ashrafi91/SmartPlant/ATmega328P_LCD_BMP180_LM35_Moisture_sensors/Pictures/ATmega328P_LCD_BMP180_LM35_Moisture_sensors_3.jpg

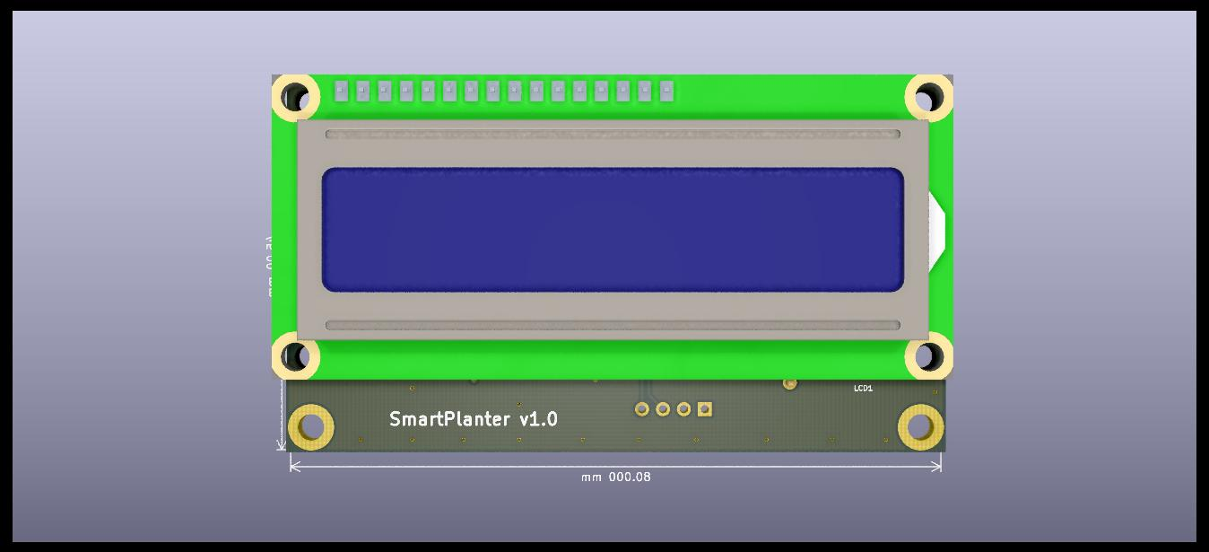
ATmega328P_LCD_BMP180_LM35_Moisture_sensors/Pictures/ATmega328P_LCD_BMP180_LM35_Moisture_sensors_3.jpg
