ashrafi91/SmartPlant/1st Version Enclosure S1/Render A.jpg

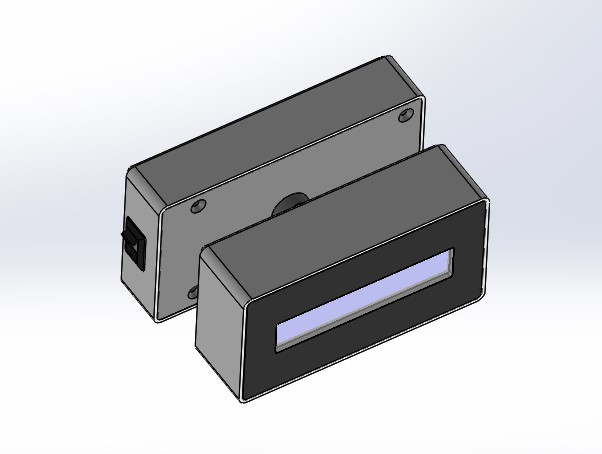
1st Version Enclosure S1/Render A.jpg
