ashrafi91/SmartPlant/1st Version Enclosure S1/Render B.jpg

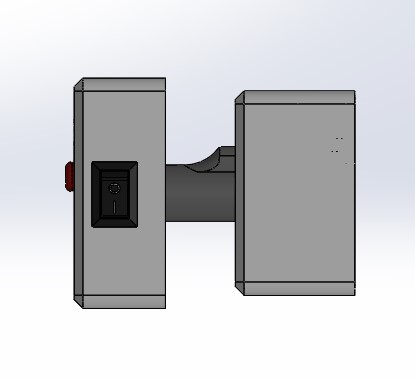
1st Version Enclosure S1/Render B.jpg
