ashrafi91/SmartPlant/1st Version Enclosure S1/Render C.jpg

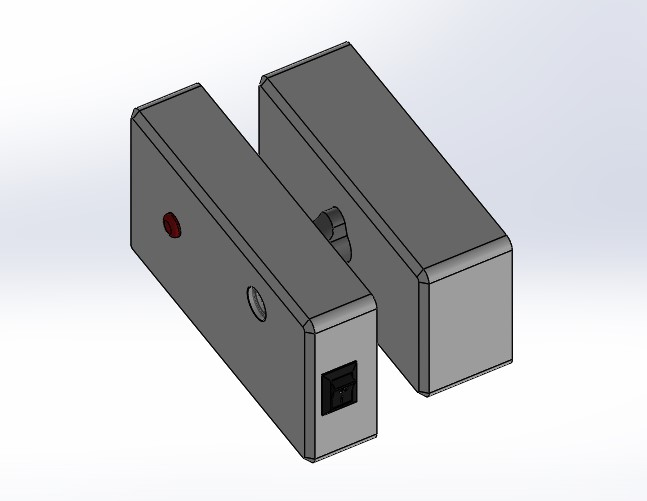
1st Version Enclosure S1/Render C.jpg
