ashrafi91/SmartPlant/1st Version Enclosure S1/Render D.jpg

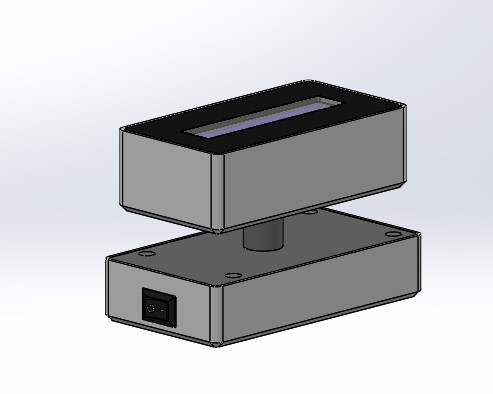
1st Version Enclosure S1/Render D.jpg
