ashrafi91/SmartPlant/Base.PNG

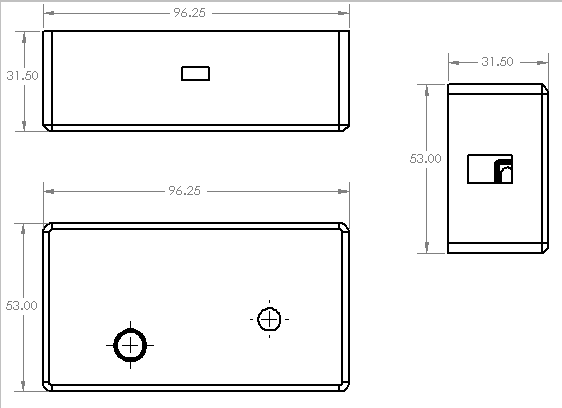
Base.PNG
