ashrafi91/SmartPlant/Enclosure V2/Render Z.png

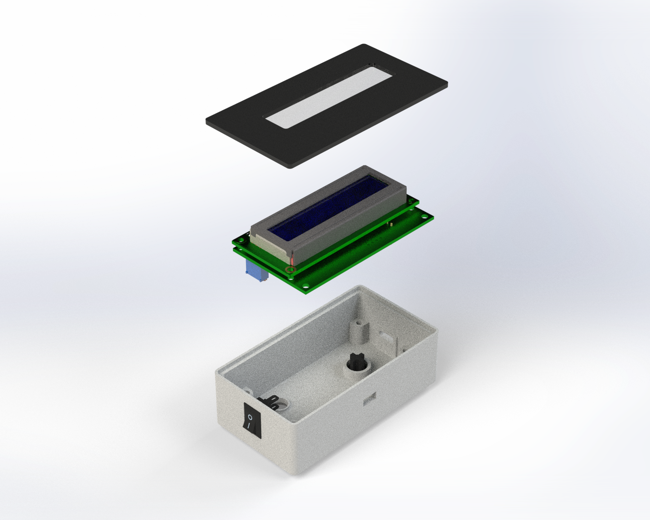
Enclosure V2/Render Z.png
