ashrafi91/SmartPlant/images (81).jpeg

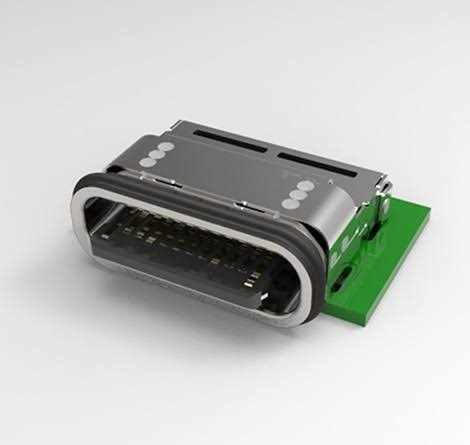
images (81).jpeg
