ashrafi91/SmartPlant/Screenshot_380.jpg

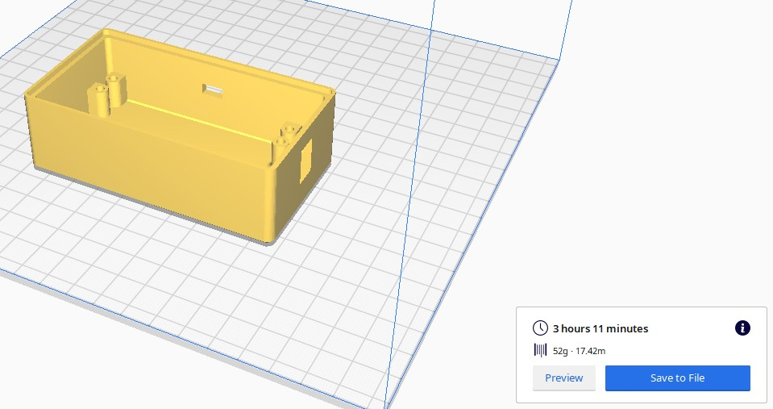
Screenshot_380.jpg
