ashrafi91/SmartPlant/SmartPlant Web App 29.12.2021/images/image-2-3.webp

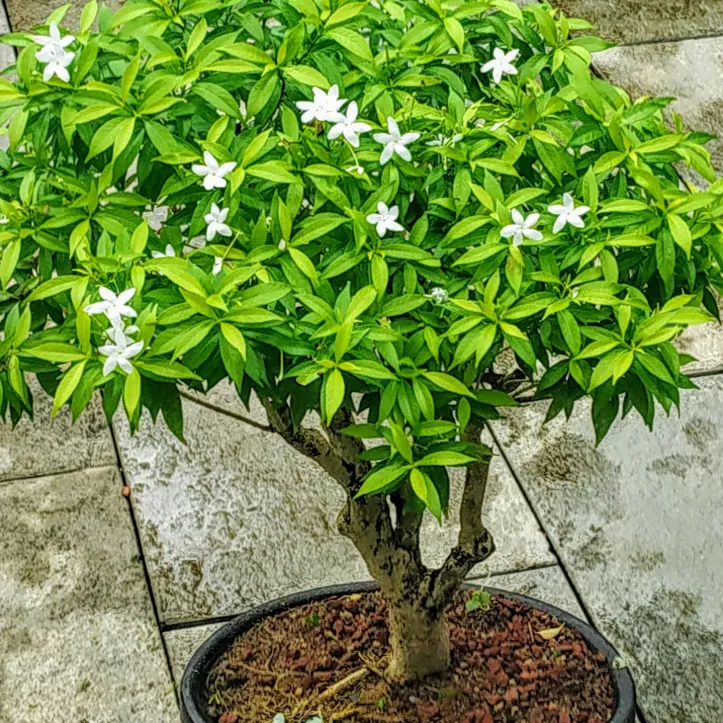
SmartPlant Web App 29.12.2021/images/image-2-3.webp
