ashrafi91/SmartPlant/ATmega328P_LCD_BMP180_LM35_Moisture_sensors/BOM/Bill of Materials - BOM.xlsx

Designator | Comment | Quantity | Footprint | Manufacturer Name | Manufacturer Part Number | LCSC Part Number
C12,C10,C6,C3,C1 | 22uF | 5 | C_0805_2012Metric | Samsung Electro-Mechanics | CL21A226MAQNNNE | C45783
C14,C13,C11,C9,C8,C7,C5,C2 | 100nF | 8 | C_0402_1005Metric | Samsung Electro-Mechanics | CL05B104KO5NNNC | C1525
C4 | 10uF | 1 | CP_EIA-3216-18_Kemet-A | AVX | TAJA106K016RNJ | C7171
C16,C15 | 15pF | 2 | C_0402_1005Metric | FH(Guangdong Fenghua Advanced Tech) | 0402CG150J500NT | C1548
D1 | SS34 | 1 | D_SMA | MDD（Microdiode Electronics） | SS34 | C8678
D2 | LEDG | 1 | LED_0603_1608Metric | Everlight Elec | 19-217/GHC-YR1S2/3T | C72043
D3 | LEDR | 1 | LED_0603_1608Metric | Hubei KENTO Elec | KT-0603R | C2286
D4 | B5819W SL | 1 | D_SOD-123 | Changjiang Electronics Tech (CJ) | B5819W SL | C8598
D5 | PWR | 1 | LED_0805_2012Metric | Hubei KENTO Elec | KT-0603R | C2286
J1 | Moisture Sensor | 1 | PinSocket_1x04_P2.54mm_Vertical | DNP | DNP | DNP | https://artofcircuits.com/product/fc-28-soil-moisture-sensor-analog-and-digital-outputs
J2 | BATT | 1 | PinHeader_1x02_P2.54mm_Vertical | DNP | DNP | DNP
J3 | USB_C_Receptacle_USB2.0 | 1 | USB_C_Receptacle_HRO_TYPE-C-31-M-12 | Korean Hroparts Elec | TYPE-C-31-M-12 | C165948
J4 | DS18B20 | 1 | PinHeader_1x03_P2.54mm_Vertical | DNP | DNP | DNP | http://denkovi.com/ds18b20-temperature-sensor-waterproof-1m-range
J5 | BMP180 | 1 | HDR-TH_5P-P2.54-V-M | Ckmtw(Shenzhen Cankemeng) | B-2100S05P-A110 | C124379
J6 | ICSP | 1 | HDR-TH_6P-P2.54-V-M-R2-C3-S2.54 | XFCN | PZ254V-12-6P | C492420
J7 | PROGRAMMING | 1 | HDR-TH_4P-P2.54-V_A2541HWV-4P | CJT(Changjiang Connectors) | A2541HWV-4P | C225501
LCD1 | LCM1602K-NSW-BBW | 1 | LCD-16X2 | Longtech Optics | LCM1602K-NSW-BBW | C83275
L1 | 22uH | 1 | L_7.3x7.3_H4.5 | SXN(Shun Xiang Nuo Elec) | SMRH74-220MT | C27442
R1,R2 | 5.1K | 2 | R_0402_1005Metric | UNI-ROYAL(Uniroyal Elec) | 0402WGF5101TCE | C25905
R15,R14,R13,R10,R7,R4,R3 | 1K | 7 | R_0402_1005Metric | Uniroyal Elec | 0402WGF1001TCE | C11702
R5 | 7.5K | 1 | R_0402_1005Metric | Uniroyal Elec | 0402WGF7501TCE | C25918
R6 | 1.2K | 1 | R_0402_1005Metric | UNI-ROYAL(Uniroyal Elec) | 0402WGF1201TCE | C25862
R8 | 4.7K | 1 | R_0402_1005Metric | UNI-ROYAL(Uniroyal Elec) | 0402WGF4701TCE | C25900
R9 | LDR 5506 | 1 | R_LDR_5.0x4.1mm_P3mm_Vertical | DNP | DNP | DNP
R17,R12,R11 | 10K | 3 | R_0402_1005Metric | UNI-ROYAL(Uniroyal Elec) | 0402WGF1002TCE | C25744
R16 | 2K | 1 | R_0402_1005Metric | UNI-ROYAL(Uniroyal Elec) | 0402WGF2001TCE | C4109
RV1 | 10K | 1 | Potentiometer_Bourns_3296W_Vertical | BOCHEN(Chengdu Guosheng Tech) | 3296W-1-103 | C118954
SW1 | ON/OFF | 1 | PinHeader_1x03_P2.54mm_Vertical | DNP | DNP | DNP
SW2 | RESET | 1 | SW_SPST_SKQG_WithoutStem | XKB Connectivity | TS-1187A-B-A-B | C318884
U1 | MT3608 | 1 | SOT-23-6 | XI'AN Aerosemi Tech | MT3608 | C84817 (https://lcsc.com/product-detail/DC-DC-Converters_MT3608_C84817.html/?href=jlc-SMT)
U2 | TP4056 | 1 | HSOP-8-1EP_3.9x4.9mm_P1.27mm_EP2.41x3.1mm | Nanjing Extension Microelectronics | TP4056-42-ESOP8 | C16581 (https://lcsc.com/product-detail/PMIC-Battery-Management_TP4056_C16581.html/?href=jlc-SMT)
U3 | AMS1117-3.3 | 1 | SOT-223-3_TabPin2 | Advanced Monolithic Systems | AMS1117-3.3 | C6186
U4 | ESP-01 | 1 | WIFIM-TH | Ai-Thinker | ESP-01 | C503581
U5 | LM35DZ/LFT1 | 1 | TO-92L_Inline | Texas Instruments | LM35DZ/LFT1 | C181511
U6 | ATMEGA328P_TQFP | 1 | TQFP-32_7x7mm_P0.8mm | Microchip Tech | ATMEGA328P-AU | C14877
Y1 | 16MHz | 1 | Crystal_SMD_3225-4Pin_3.2x2.5mm | Yangxing Tech | X322516MLB4SI | C13738
