ashrafi91/SmartPlant/1st Version Enclosure S1/LCD Case/Base/Base LCD.STEP

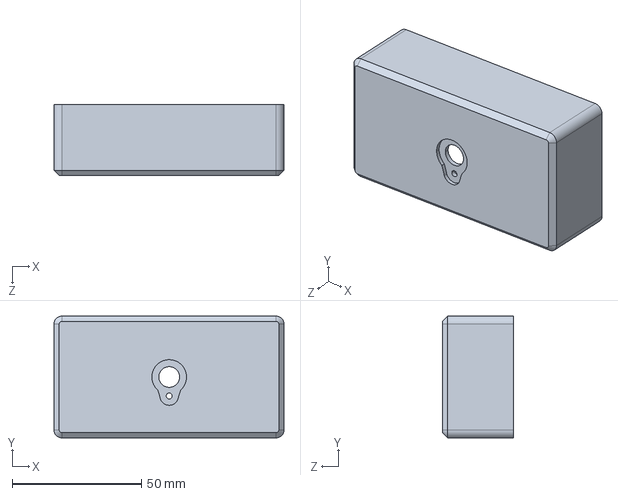
[picture p13: CAD file, 2021-12-19]
1st Version Enclosure S1/LCD Case/Base/Base LCD.STEP
88.9 x 47.0 x 27.5 mm
