ashrafi91/SmartPlant/1st Version Enclosure S1/PCB Case/Base/Base PCB.STEP

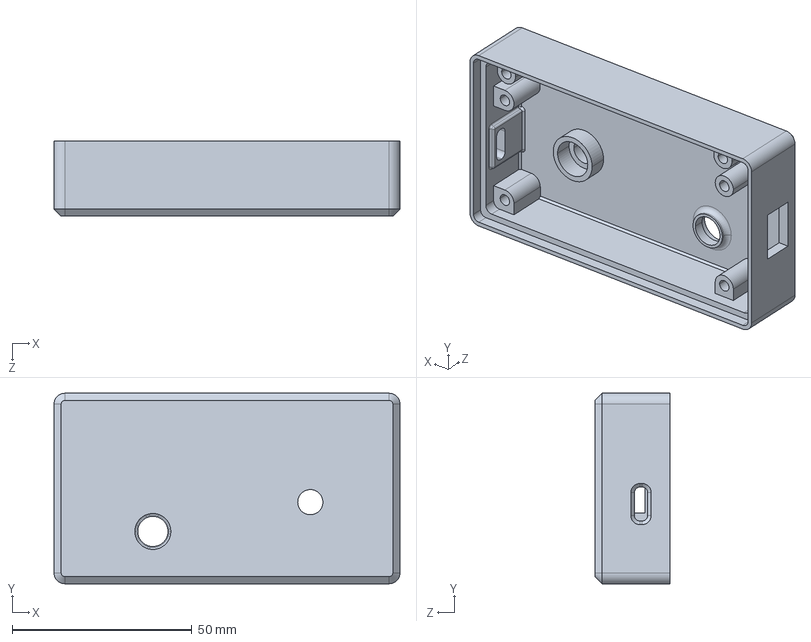
[picture p14: CAD file, 2021-12-19]
1st Version Enclosure S1/PCB Case/Base/Base PCB.STEP
96.3 x 53.0 x 21.0 mm
