ashrafi91/SmartPlant/1st Version Enclosure S1/PCB Case/Lid with Bridge/Lid PCB with Bridge.STEP

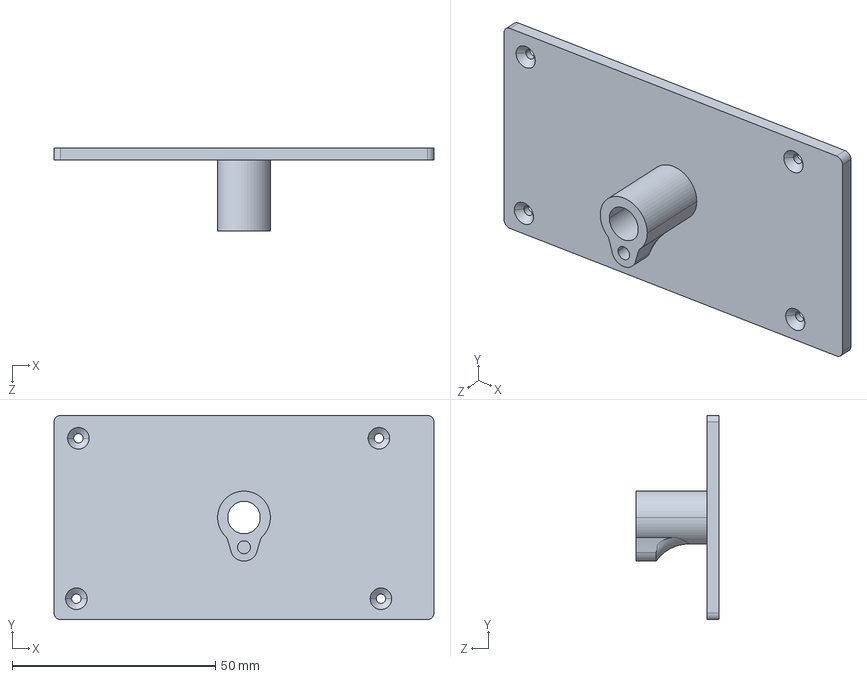
[picture p15: CAD file, 2021-12-19]
1st Version Enclosure S1/PCB Case/Lid with Bridge/Lid PCB with Bridge.STEP
93.6 x 50.3 x 20.5 mm
