ashrafi91/SmartPlant/1st Version Enclosure S1/PCB Case/Switch/Switch.STEP

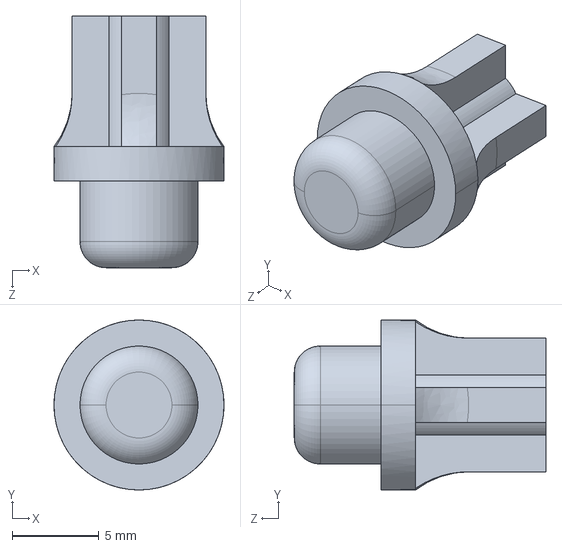
[picture p16: CAD file, 2021-12-19]
1st Version Enclosure S1/PCB Case/Switch/Switch.STEP
9.80 x 9.80 x 14.5 mm
