ashrafi91/SmartPlant/Enclosure V2/Base Part (3d Print)/Base.STEP

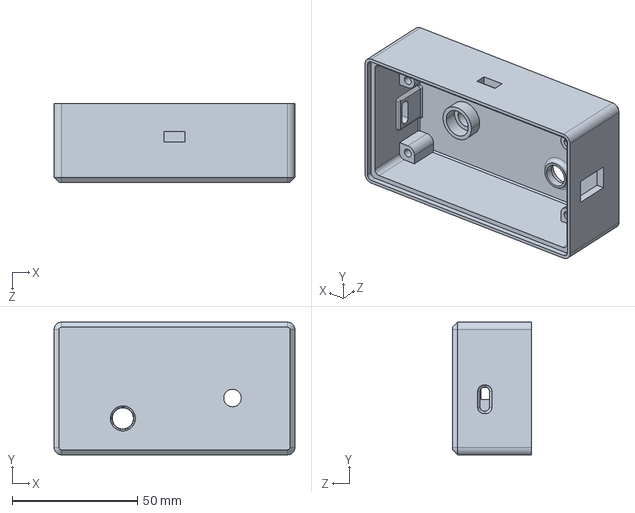
[picture p17: CAD file, 2021-12-19]
Enclosure V2/Base Part (3d Print)/Base.STEP
96.3 x 53.0 x 31.5 mm
