ashrafi91/SmartPlant/(list of files, cad)

Other CAD files:
Enclosure V2/Modified Base (3D print)/Base.STEP
Enclosure V1/Base Part (3d Print)/Base.STEP
1st Version Enclosure S1/LCD Case/Base/Base LCD.STL
1st Version Enclosure S1/PCB Case/Base/Base PCB.STL
1st Version Enclosure S1/PCB Case/Lid with Bridge/Lid PCB with Bridge.STL
1st Version Enclosure S1/PCB Case/Switch/Switch.STL
Enclosure V1/Base Part (3d Print)/Base.STL
Enclosure V1/Switch (3d Print)/Switch.STL
Enclosure V2/Base Part (3d Print)/Base.STL
Enclosure V2/Modified Base (3D print)/Base.STL
Enclosure V2/Switch (3d Print)/Switch.STL
