ashrafi91/SmartPlant/ATmega328P_LCD_BMP180_LM35_Moisture_sensors/Schematic/ATmega328P_LCD_BMP180_LM35_Moisture_sensors.pdf

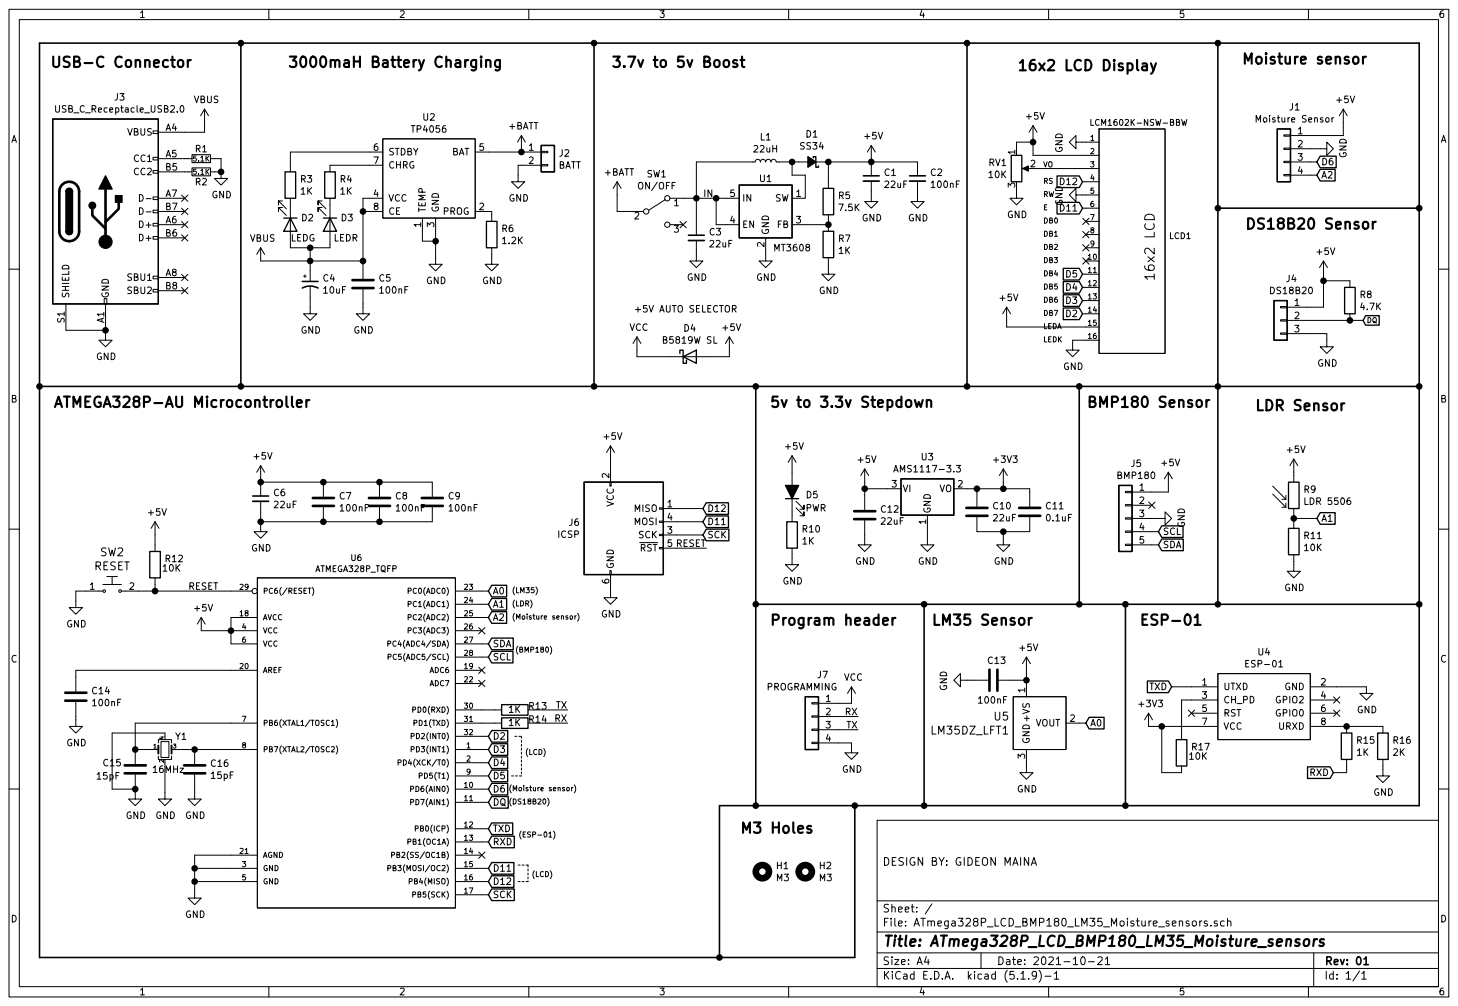
[picture p18: page 1]

+5V AUTO SELECTOR 3000maH Battery Charging

3 VCC 4 BAT 5 STDBY 6 CHRG 7 CE 8 U2 TP4056 GND GND

2 SCK 3 MOSI 4 RST 5 GND

File: ATmega328P_LCD_BMP180_LM35_Moisture_sensors.sch Sheet: / DESIGN BY: GIDEON MAINA
