ashrafi91/SmartPlant/Updated Fritzing/updated_schematic.pdf

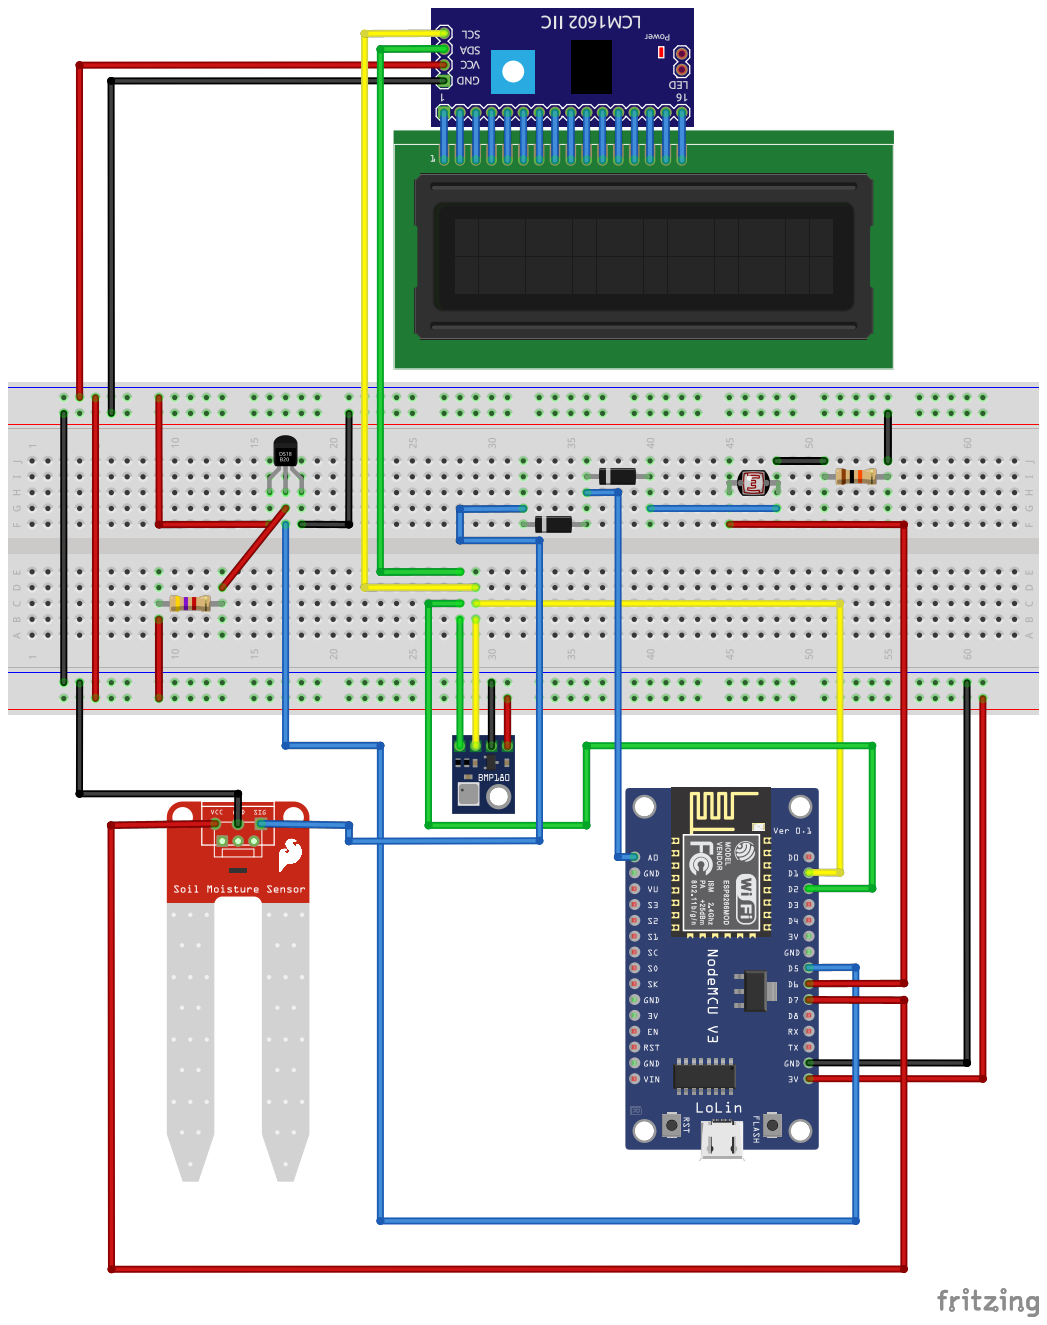
[picture p19: page 1]
