ashrafi91/SmartPlant/(list of files, drawings)

Other design files:
Updated Fritzing/updated_fritzing.fzz
