ashrafi91/SmartPlant/Enclosure V2/Lid (Lasercut & UV printing)/Dimensions.jpg

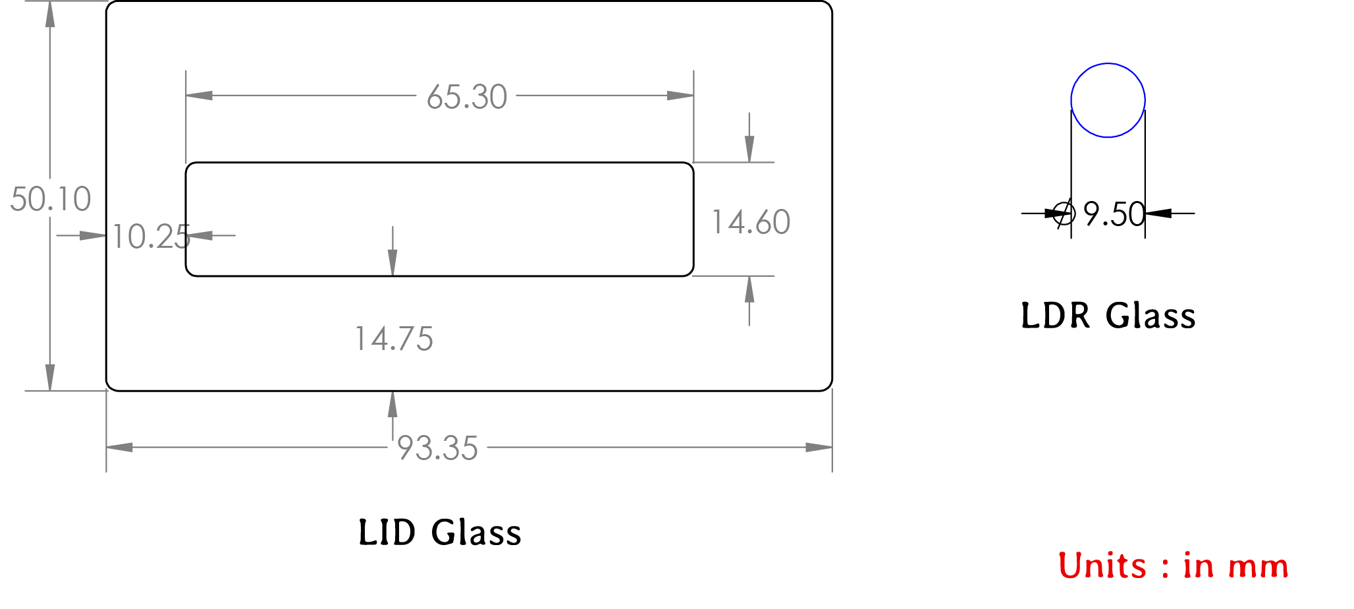
Enclosure V2/Lid (Lasercut & UV printing)/Dimensions.jpg
