ashrafi91/SmartPlant/(commit log)

2021-12-19 first release
    [Base LCD.STEP, Base LCD.STL, Base PCB.STEP, Base PCB.STL, Base.STEP, Base.STL, Bill of Materials - BOM.xlsx, Lid PCB with Bridge.STEP]
2022-01-09 Second commit
    [updated_fritzing.fzz]
