ashrafi91/SmartPlant/(notices)

Notices in the files:
SmartPlant Web App 29.12.2021/README.md:
License: MIT
